lucasleale/Ekoparty_Badge_2025/2D_PCB1_2025-10-20.png

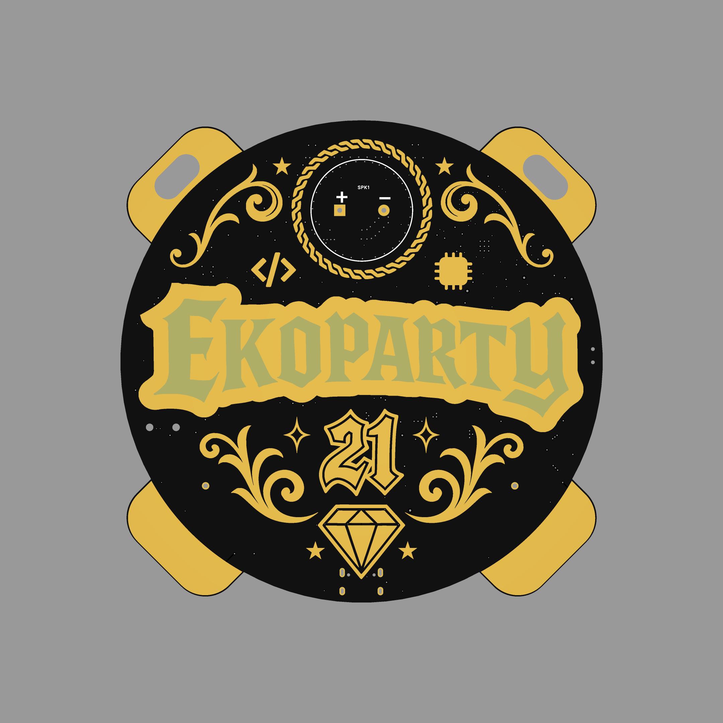
2D_PCB1_2025-10-20.png
