lucasleale/Ekoparty_Badge_2025/Firmware/Ekoparty_DrDre/fscale.h

float fscale( float inputValue, float originalMin, float originalMax, float newBegin, float
              newEnd, float curve) {

  float OriginalRange = 0;
  float NewRange = 0;
  float zeroRefCurVal = 0;
  float normalizedCurVal = 0;
  float rangedValue = 0;
  boolean invFlag = 0;



  if (curve > 10) curve = 10;
  if (curve < -10) curve = -10;

  curve = (curve * -.1) ;
  curve = pow(10, curve);


  if (inputValue < originalMin) {
    inputValue = originalMin;
  }
  if (inputValue > originalMax) {
    inputValue = originalMax;
  }


  OriginalRange = originalMax - originalMin;

  if (newEnd > newBegin) {
    NewRange = newEnd - newBegin;
  }
  else
  {
    NewRange = newBegin - newEnd;
    invFlag = 1;
  }

  zeroRefCurVal = inputValue - originalMin;
  normalizedCurVal  =  zeroRefCurVal / OriginalRange;

  /*
    Serial.print(OriginalRange, DEC);
    Serial.print("   ");
    Serial.print(NewRange, DEC);
    Serial.print("   ");
    Serial.println(zeroRefCurVal, DEC);
    Serial.println();
  */


  if (originalMin > originalMax ) {
    return 0;
  }

  if (invFlag == 0) {
    rangedValue =  (pow(normalizedCurVal, curve) * NewRange) + newBegin;

  }
  else
  {
    rangedValue =  newBegin - (pow(normalizedCurVal, curve) * NewRange);
  }

  return rangedValue;
}
