lucasleale/Ekoparty_Badge_2025/(commit log)

2025-10-20 Add script raw sample
2025-10-20 Add notch filters lib
